lhr-solar/Controls-PedalBoard/README.md

# Controls-PedalBoard
Pedal Daughter Board to mate with the PeripheralSOM for sensing of the linear potentiometers and brake line sensor
