lhr-solar/Controls-PedalBoard/hardware/VCAT-HallEffectPotentiometerPCB/VCAT-HallEffectPotentiometerPCB.step

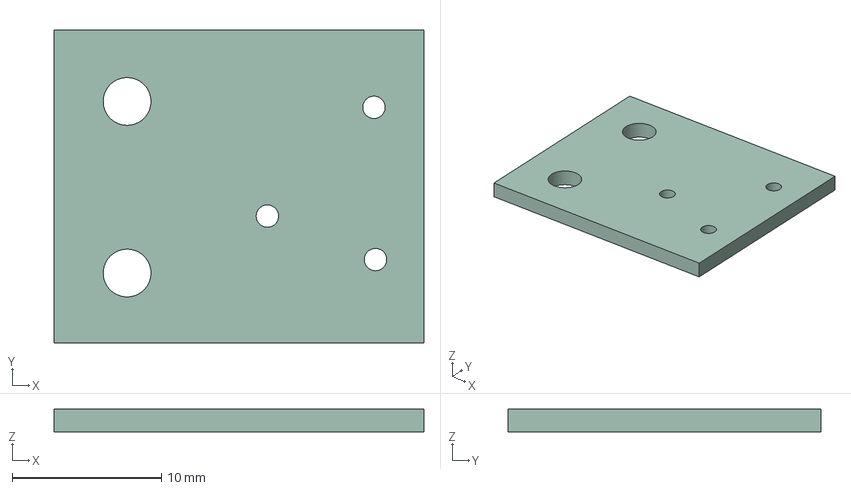
[picture p1: CAD file, 2026-01-18]
hardware/VCAT-HallEffectPotentiometerPCB/VCAT-HallEffectPotentiometerPCB.step
24.8 x 21.0 x 1.51 mm
