lhr-solar/Controls-PedalBoard/hardware/VCAT-PedalBoxPCB/3D Models/INA241A5IDR.stp

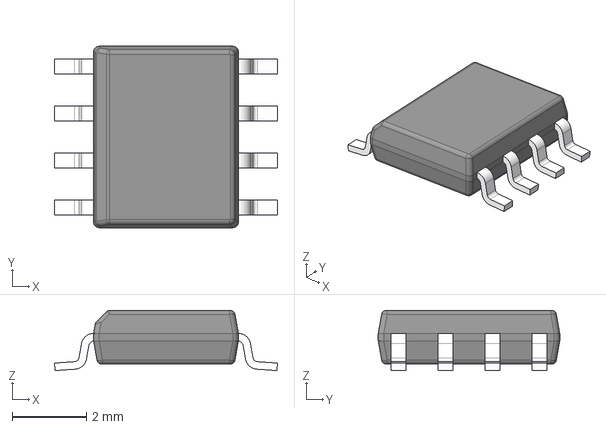
[picture p2: CAD file, 2026-01-18]
hardware/VCAT-PedalBoxPCB/3D Models/INA241A5IDR.stp
6.02 x 4.90 x 1.63 mm
BODY-SO
LEAD-D0008A x 8
