lhr-solar/Controls-PedalBoard/hardware/VCAT-PedalBoxPCB/Controls-PedalsDaughter.step

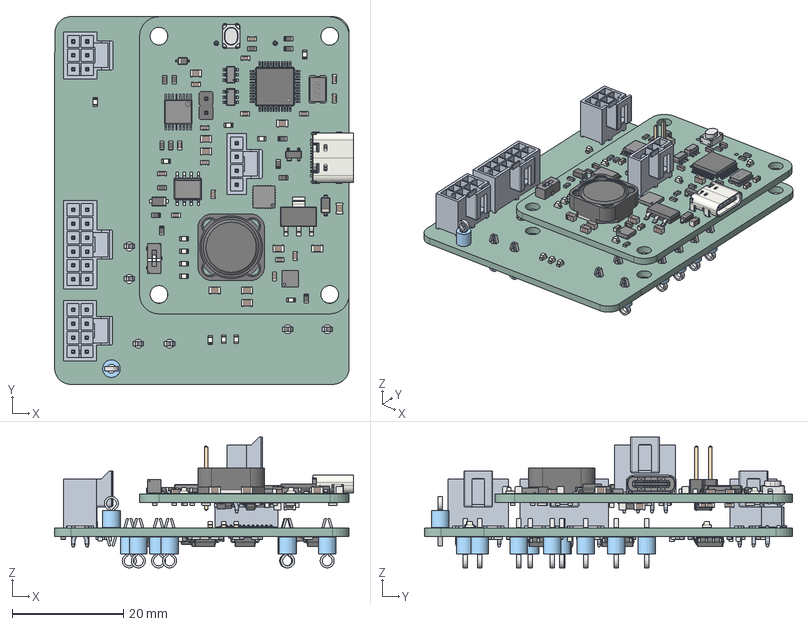
[picture p3: CAD file, 2026-01-18]
hardware/VCAT-PedalBoxPCB/Controls-PedalsDaughter.step
53.8 x 66.2 x 23.6 mm
TestPoint_Keystone_5005-5009_Compact x 17
LED_0603_1608Metric x 13
C_0603_1608Metric x 42
D_SOD-123F x 2
ThermalPin
PinsArrayLR x 3
PinsArrayTB
R_0603_1608Metric x 75
C_0805_2012Metric x 12
LQFP-48_7x7mm_P0.5mm
SOT-223
kicad_embedded_DC8F7DF302591227B9F71E251B6FE682
kicad_embedded_70E7614803E5E4F918B4D78DA69A18BB
L_Coilcraft_MSS1246-XXX
USB_C_Receptacle_GCT_USB4105-xx-A_16P_TopMnt_Horizontal
kicad_embedded_9406EA57197DC5EF7108E35EAA086FA7
BODY-SO x 2
LEAD-D0008A x 8
TL3365AF180QG--3DModel-STEP-520916
BODY-TSSOP
LEAD-TSSOP x 16
PIN1
DAP
SOT-143
D_SOD-123
PinHeader_1x02_P2.54mm_Vertical
D_SOD-323
SOT-23W
LEAD-SO x 8
PeripheralSOM_PCB
SOIC-8_3.9x4.9mm_P1.27mm x 5
term1 x 2
term2 x 2
AP2205-50W5-7 x 2
Controls-PedalsDaughter_PCB
