lhr-solar/Controls-PedalBoard/hardware/VCAT-PedalBoxPCB/3D Models/RI3-1205S.stp

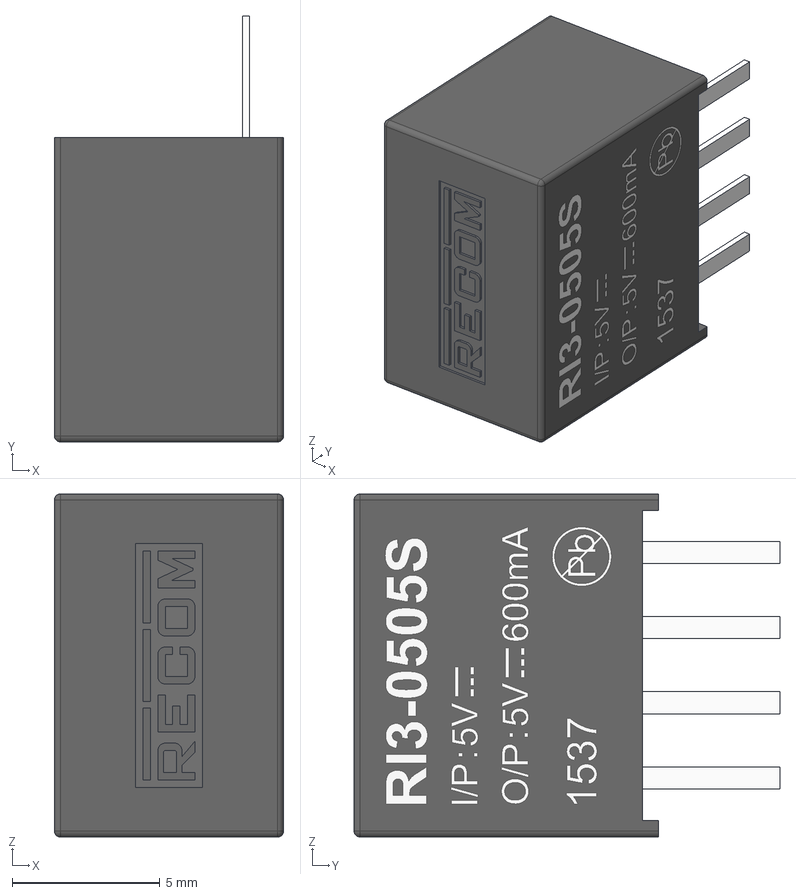
[picture p4: CAD file, 2026-01-18]
hardware/VCAT-PedalBoxPCB/3D Models/RI3-1205S.stp
7.75 x 14.4 x 11.6 mm
