lhr-solar/Controls-PedalBoard/hardware/VCAT-PedalBoxPCB/3D Models/REF5025AID.step

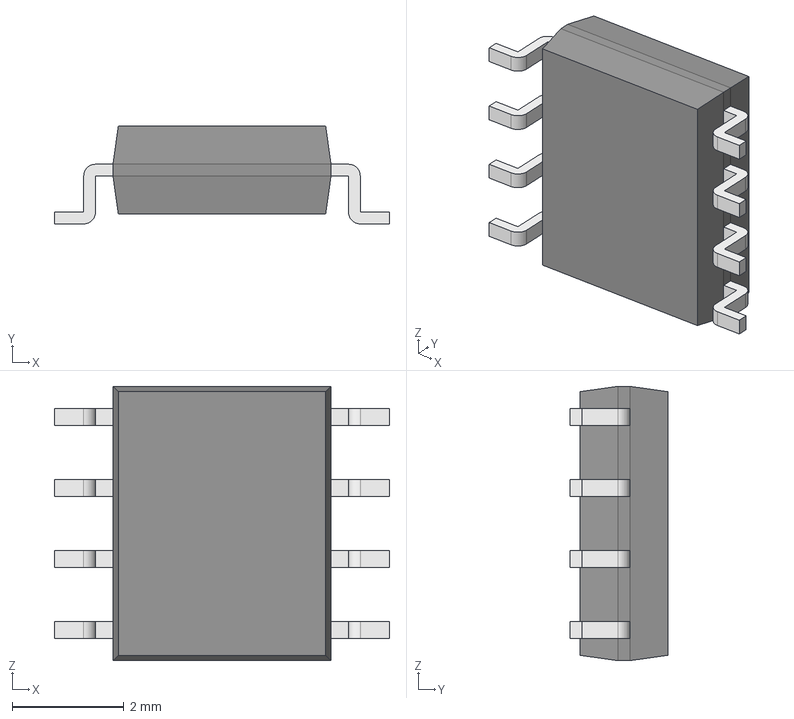
[picture p5: CAD file, 2026-01-18]
hardware/VCAT-PedalBoxPCB/3D Models/REF5025AID.step
5.99 x 1.75 x 4.91 mm
Body001 (Mirror #1) x 4
XY-plane x 12
X-axis x 12
