lhr-solar/Controls-PedalBoard/hardware/VCAT-PedalBoxPCB/3D Models/AP2205-50W5-7.STEP

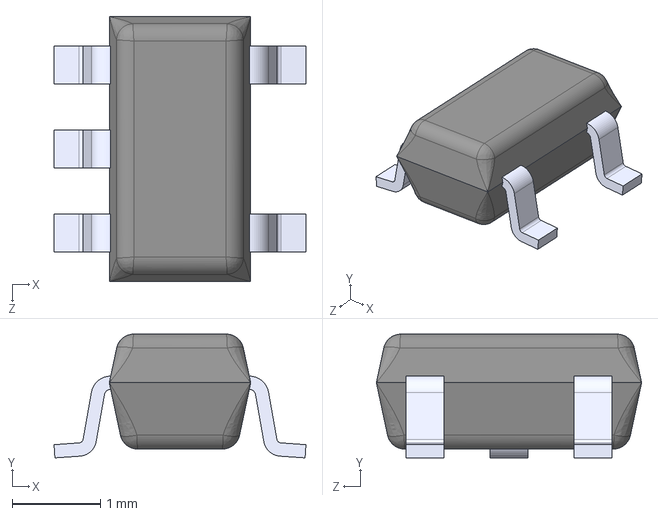
[picture p6: CAD file, 2026-01-18]
hardware/VCAT-PedalBoxPCB/3D Models/AP2205-50W5-7.STEP
2.85 x 1.40 x 3.00 mm
