lhr-solar/Controls-PedalBoard/hardware/VCAT-PedalBoxPCB/3D Models/2x4_vert.stp

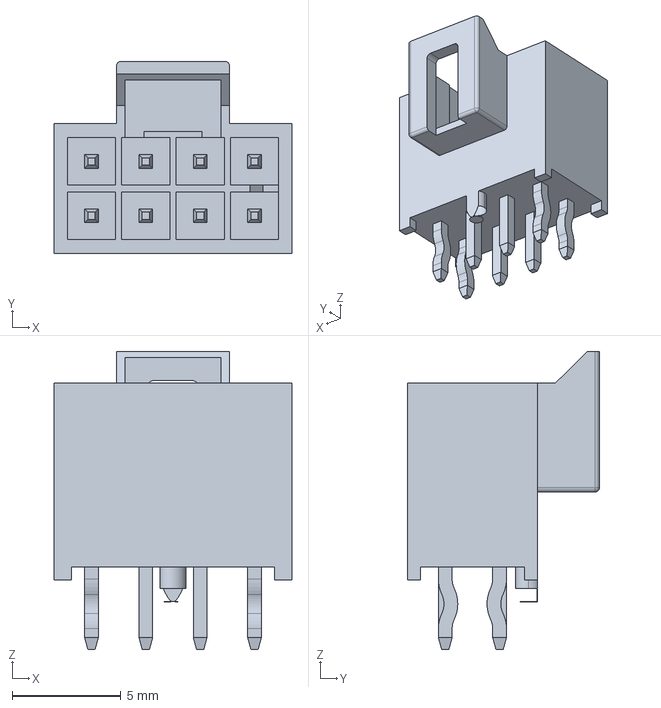
[picture p7: CAD file, 2026-01-18]
hardware/VCAT-PedalBoxPCB/3D Models/2x4_vert.stp
10.9 x 8.84 x 13.7 mm
