lhr-solar/Controls-PedalBoard/hardware/VCAT-PedalBoxPCB/3D Models/2x6_vert.stp

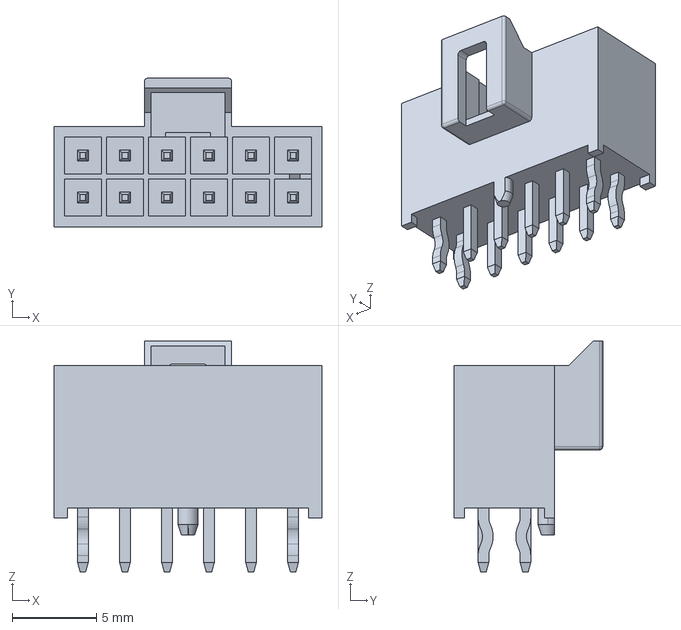
[picture p8: CAD file, 2026-01-18]
hardware/VCAT-PedalBoxPCB/3D Models/2x6_vert.stp
15.9 x 8.84 x 13.7 mm
