lhr-solar/Controls-PedalBoard/hardware/VCAT-PedalBoxPCB/3D Models/AMC1300BDWV.step

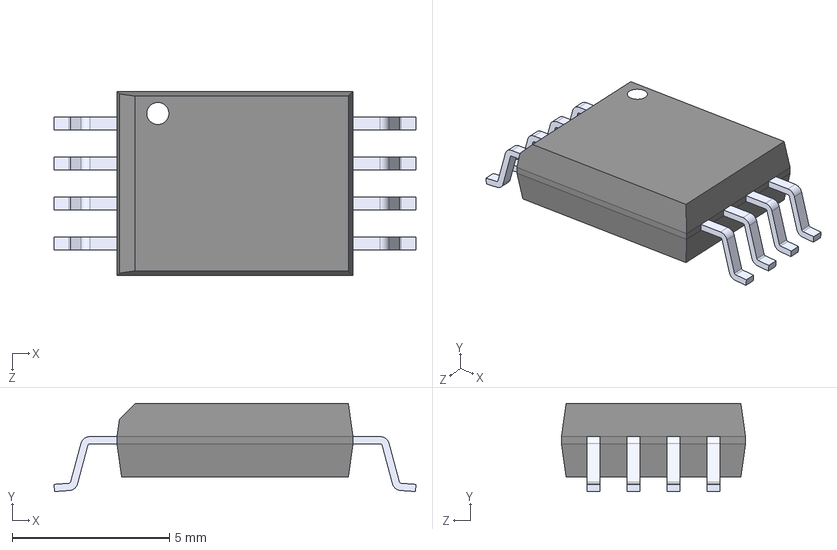
[picture p9: CAD file, 2026-01-18]
hardware/VCAT-PedalBoxPCB/3D Models/AMC1300BDWV.step
11.5 x 2.80 x 5.85 mm
