lhr-solar/Controls-PedalBoard/hardware/VCAT-PedalBoxPCB/3D Models/2x3_vertical_nanofit.stp

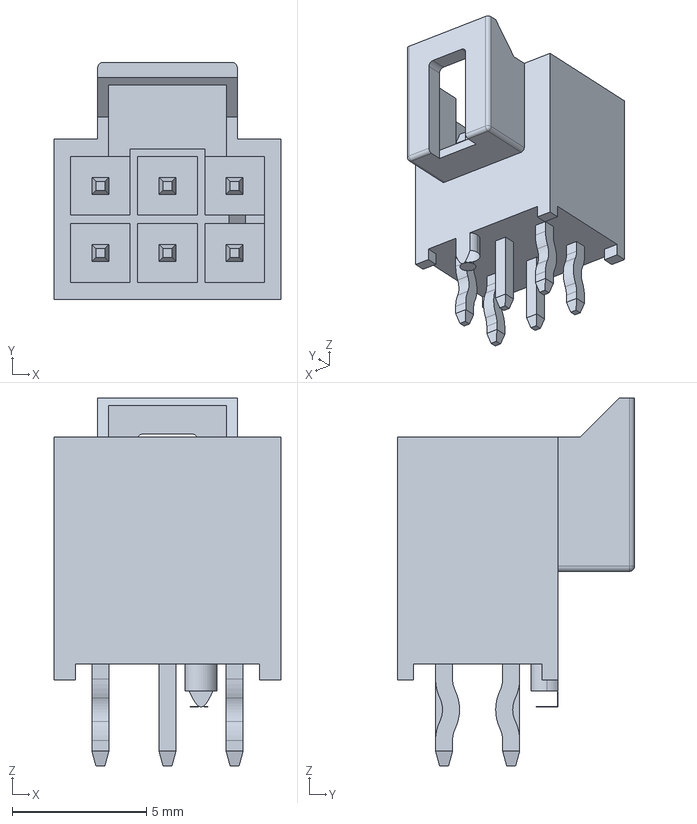
[picture p10: CAD file, 2026-01-18]
hardware/VCAT-PedalBoxPCB/3D Models/2x3_vertical_nanofit.stp
8.44 x 8.84 x 13.7 mm
