lhr-solar/Controls-PedalBoard/hardware/VCAT-PedalBoxPCB/3D Models/ADP7182AUJZ-R7.stp

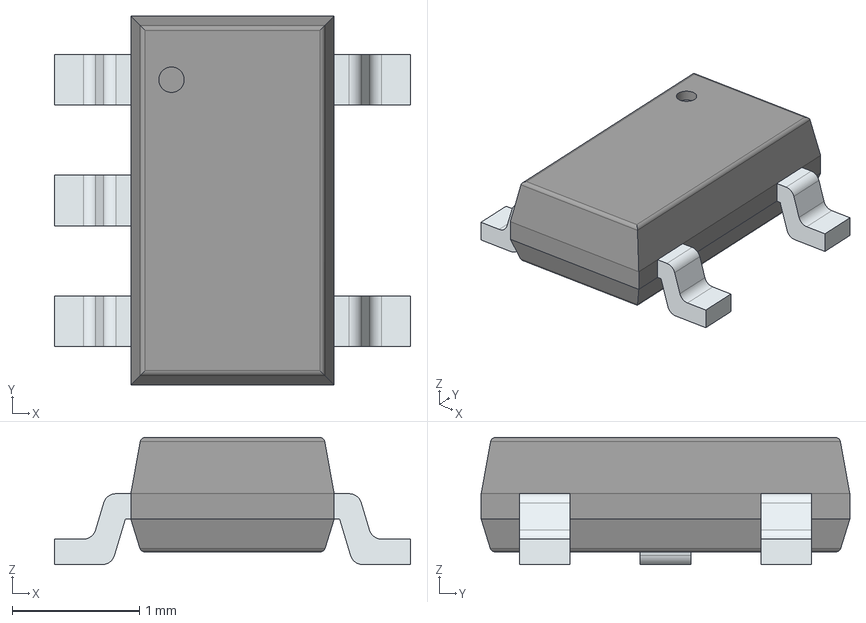
[picture p11: CAD file, 2026-01-18]
hardware/VCAT-PedalBoxPCB/3D Models/ADP7182AUJZ-R7.stp
2.80 x 2.90 x 1.00 mm
PinsArrayL
PinsArrayR
