lhr-solar/Controls-PedalBoard/hardware/VCAT-PedalBoxPCB/3D Models/1x2vert.stp

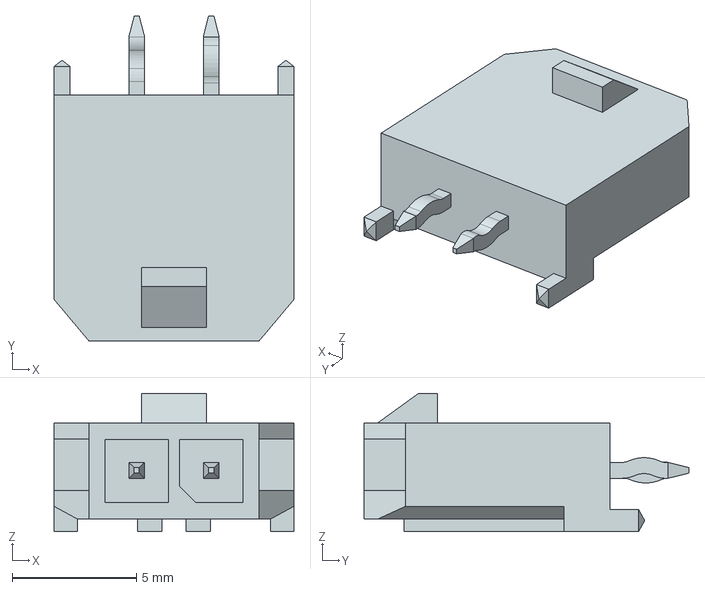
[picture p12: CAD file, 2026-01-18]
hardware/VCAT-PedalBoxPCB/3D Models/1x2vert.stp
9.65 x 13.1 x 5.57 mm
