lhr-solar/Controls-PedalBoard/hardware/VCAT-PedalBoxPCB/3D Models/0603L025YR.stp

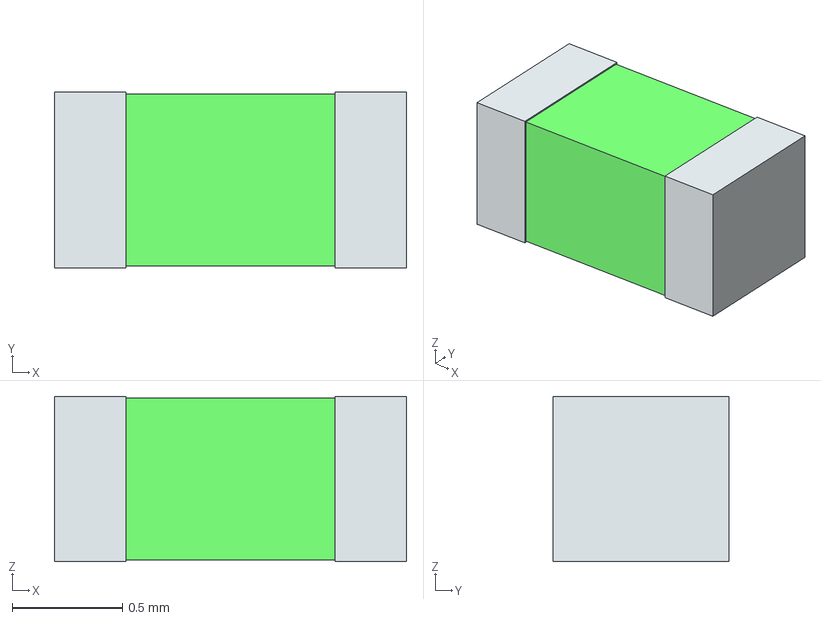
[picture p13: CAD file, 2026-01-18]
hardware/VCAT-PedalBoxPCB/3D Models/0603L025YR.stp
1.60 x 0.8 x 0.75 mm
term1
term2
