lhr-solar/Controls-PedalBoard/hardware/VCAT-PedalBoxPCB/Controls-PedalsDaughter.kicad_pcb

## KiCad design hardware/VCAT-PedalBoxPCB/Controls-PedalsDaughter.kicad_pcb (2026-01-18)

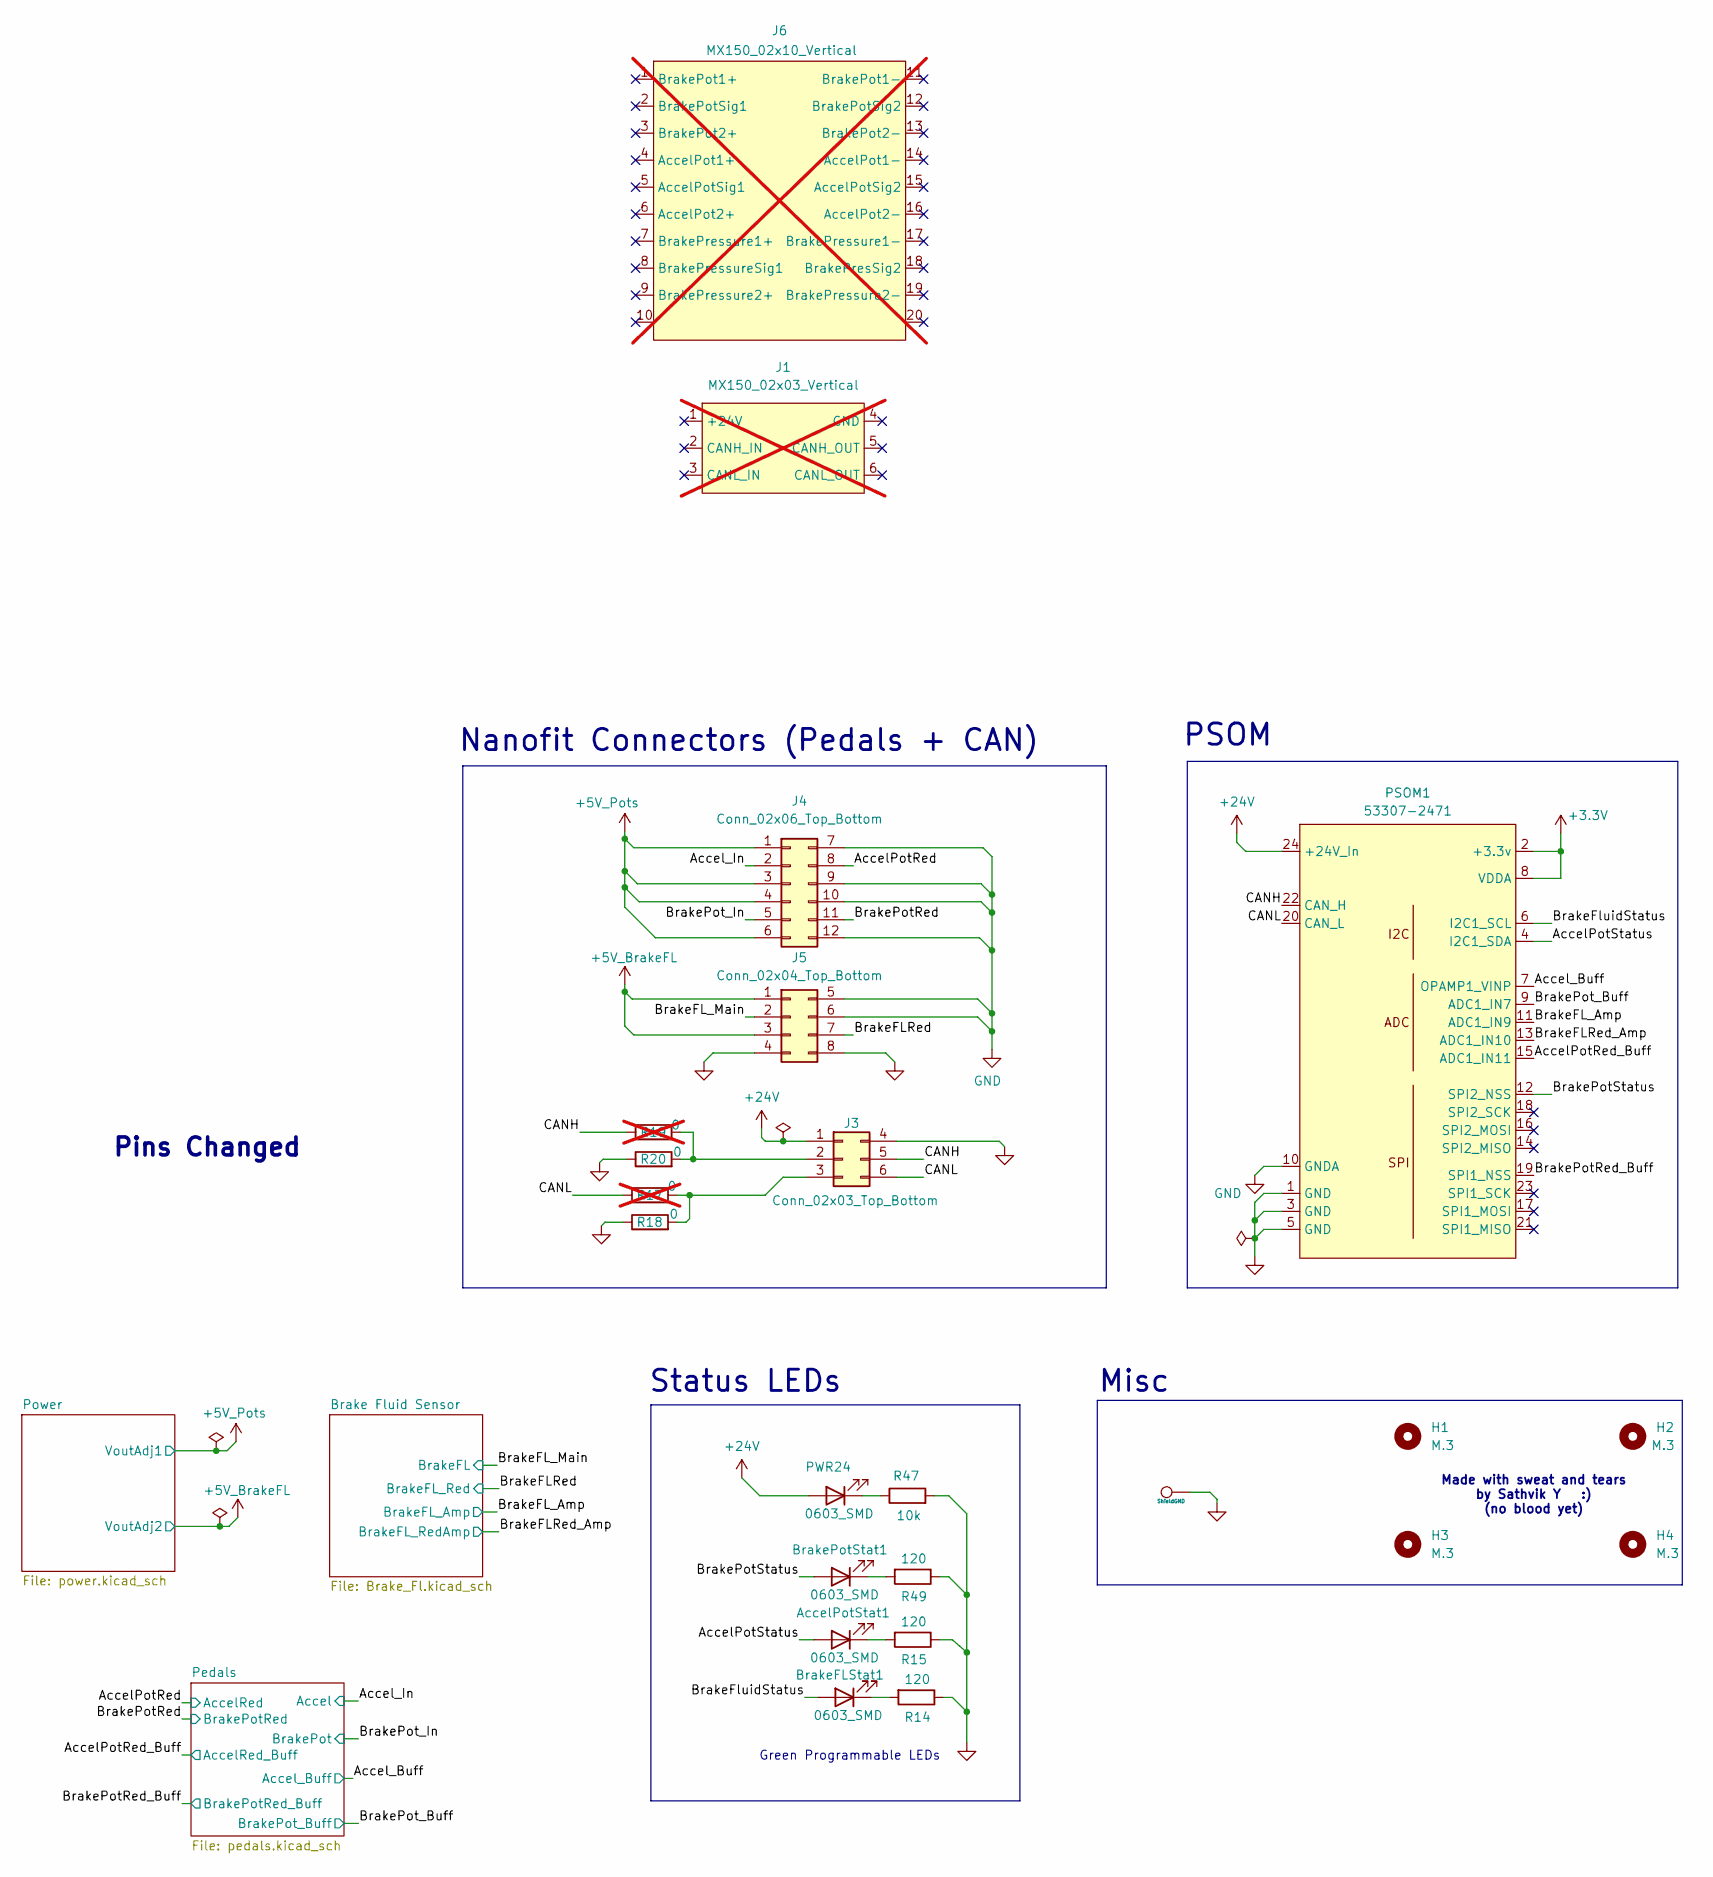
[picture p14: schematic Controls-PedalsDaughter.kicad_sch]

Parts:
AccelPotStat1: 0603_SMD; LED_0603_1608Metric_Pad1.05x0.95mm_HandSolder
BrakeFLStat1: 0603_SMD; LED_0603_1608Metric_Pad1.05x0.95mm_HandSolder
BrakePotStat1: 0603_SMD; LED_0603_1608Metric_Pad1.05x0.95mm_HandSolder
H1, H2, H3, H4: M.3; MountingHole_3.2mm_M3_Pad_TopBottom
J1: MX150_02x03_Vertical; not fitted
J3: Conn_02x03_Top_Bottom; Molex_Nano-Fit_105310-xx06_2x03_P2.50mm_Vertical
J4: Conn_02x06_Top_Bottom; Molex_Nano-Fit_105310-xx12_2x06_P2.50mm_Vertical
J5: Conn_02x04_Top_Bottom; Molex_Nano-Fit_105310-xx08_2x04_P2.50mm_Vertical
J6: MX150_02x10_Vertical; not fitted
PSOM1: 53307-2471; PeripheralSOM
PWR24: 0603_SMD; LED_0603_1608Metric_Pad1.05x0.95mm_HandSolder
R14, R15, R49: 120; R_0603_1608Metric_Pad0.98x0.95mm_HandSolder
R17, R19: 0; R_0603_1608Metric_Pad0.98x0.95mm_HandSolder; not fitted
R18, R20: 0; R_0603_1608Metric_Pad0.98x0.95mm_HandSolder
R47: 10k; R_0603_1608Metric_Pad0.98x0.95mm_HandSolder
Raw6: ShieldGND; TestPoint_Keystone_5005-5009_Compact

Connections:
+3.3V: PSOM1.2 (+3.3v), PSOM1.8 (VDDA); also elsewhere on the board
+5V_BrakeFL: J5.1, J5.3; also elsewhere on the board
+5V_Pots: J4.1, J4.3, J4.4, J4.6; also elsewhere on the board
+24V: J3.1, PSOM1.24 (+24V_In), PWR24.2 (A); also elsewhere on the board
/AccelPotRed: J4.8; also elsewhere on the board
/AccelPotRed_Buff: PSOM1.15 (ADC1_IN11); also elsewhere on the board
/AccelPotStatus: AccelPotStat1.2 (A), PSOM1.4 (I2C1_SDA)
/Accel_Buff: PSOM1.7 (OPAMP1_VINP); also elsewhere on the board
/Accel_In: J4.2; also elsewhere on the board
/BrakeFLRed: J5.7; also elsewhere on the board
/BrakeFLRed_Amp: PSOM1.13 (ADC1_IN10); also elsewhere on the board
/BrakeFL_Amp: PSOM1.11 (ADC1_IN9); also elsewhere on the board
/BrakeFL_Main: J5.2; also elsewhere on the board
/BrakeFluidStatus: BrakeFLStat1.2 (A), PSOM1.6 (I2C1_SCL)
/BrakePotRed: J4.11; also elsewhere on the board
/BrakePotRed_Buff: PSOM1.19 (SPI1_NSS); also elsewhere on the board
/BrakePotStatus: BrakePotStat1.2 (A), PSOM1.12 (SPI2_NSS)
/BrakePot_Buff: PSOM1.9 (ADC1_IN7); also elsewhere on the board
/BrakePot_In: J4.5; also elsewhere on the board
/CANH: J3.5, PSOM1.22 (CAN_H), R19.1
/CANL: J3.6, PSOM1.20 (CAN_L), R17.1
GND: J3.4, J4.7, J4.9, J4.10, J4.12, J5.4, J5.5, J5.6, J5.8, PSOM1.1 (GND), PSOM1.3 (GND), PSOM1.5 (GND), PSOM1.10 (GNDA), R14.1, R15.1, R18.1, R20.1, R47.2, R49.1, Raw6.1; also elsewhere on the board
unnamed: AccelPotStat1.1 (K), R15.2
unnamed: BrakeFLStat1.1 (K), R14.2
unnamed: BrakePotStat1.1 (K), R49.2
unnamed: J3.2, R19.2, R20.2
unnamed: J3.3, R17.2, R18.2
unnamed: PWR24.1 (K), R47.1

Notes on the sheet:
Made with sweat and tears by Sathvik Y :) (no blood yet)
Nanofit Connectors (Pedals + CAN)
PSOM
Green Programmable LEDs
Misc
Pins Changed
Status LEDs

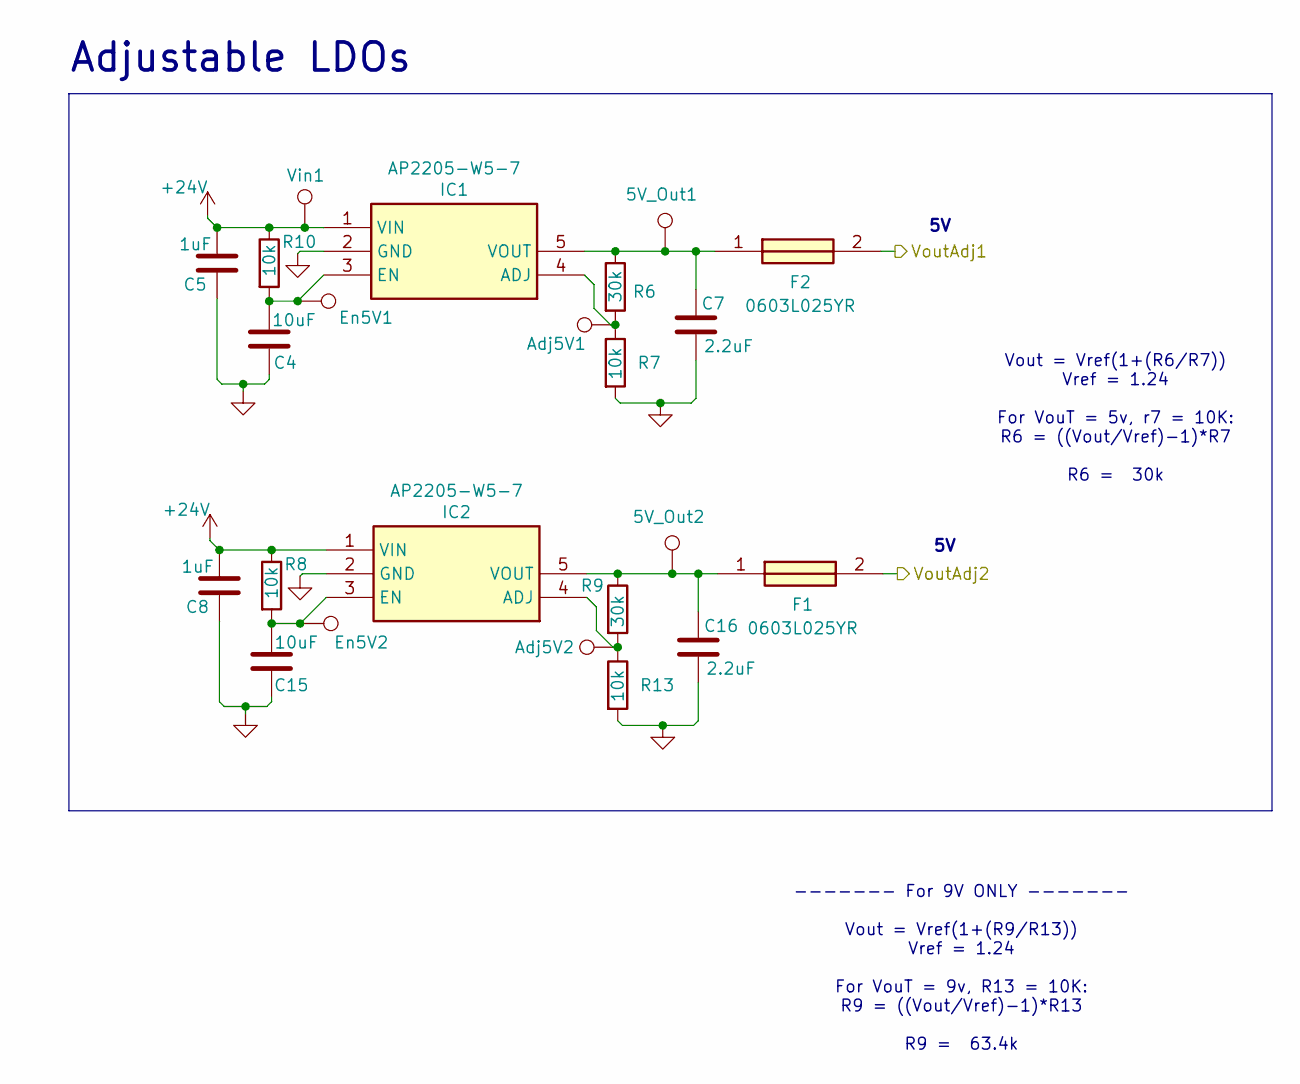
[picture p15: schematic power.kicad_sch]

Parts:
5V_Out1, 5V_Out2: 5V_Out; TestPoint_Pad_1.0x1.0mm
Adj5V1, Adj5V2: Adj5V; TestPoint_Pad_1.0x1.0mm
C4, C15: 10uF; C_0603_1608Metric_Pad1.08x0.95mm_HandSolder
C5, C8: 1uF; C_0603_1608Metric_Pad1.08x0.95mm_HandSolder
C7, C16: 2.2uF; C_0603_1608Metric_Pad1.08x0.95mm_HandSolder
En5V1, En5V2: Enable5V; TestPoint_Pad_1.0x1.0mm
F1, F2: 0603L025YR; FUSC1608X75N; Mouser Part Number 576-0603L025YR
IC1, IC2: AP2205-W5-7; AP2205W57; Mouser Part Number 621-AP2205-W5-7
R6, R9: 30k; R_0603_1608Metric_Pad0.98x0.95mm_HandSolder
R7, R8, R10, R13: 10k; R_0603_1608Metric_Pad0.98x0.95mm_HandSolder
Vin1: Vin; TestPoint_Pad_1.0x1.0mm

Connections:
+5V_BrakeFL: F1.2; also elsewhere on the board
+5V_Pots: F2.2; also elsewhere on the board
+24V: C5.2, C8.2, IC1.1 (VIN), IC2.1 (VIN), R8.1, R10.1, Vin1.1; also elsewhere on the board
GND: C4.1, C5.1, C7.2, C8.1, C15.1, C16.2, IC1.2 (GND), IC2.2 (GND), R7.2, R13.2; also elsewhere on the board
unnamed: Adj5V1.1, IC1.4 (ADJ), R6.2, R7.1
unnamed: C4.2, En5V1.1, IC1.3 (EN), R10.2
unnamed: 5V_Out1.1, C7.1, F2.1, IC1.5 (VOUT), R6.1
unnamed: Adj5V2.1, IC2.4 (ADJ), R9.2, R13.1
unnamed: C15.2, En5V2.1, IC2.3 (EN), R8.2
unnamed: 5V_Out2.1, C16.1, F1.1, IC2.5 (VOUT), R9.1

Notes on the sheet:
------- For 9V ONLY ------- Vout = Vref(1+(R9/R13)) Vref = 1.24 For VouT = 9v, R13 = 10K: R9 = ((Vout/Vref)-1)*R13 R9 = 63.4k
Vout = Vref(1+(R6/R7)) Vref = 1.24 For VouT = 5v, r7 = 10K: R6 = ((Vout/Vref)-1)*R7 R6 = 30k
Adjustable LDOs

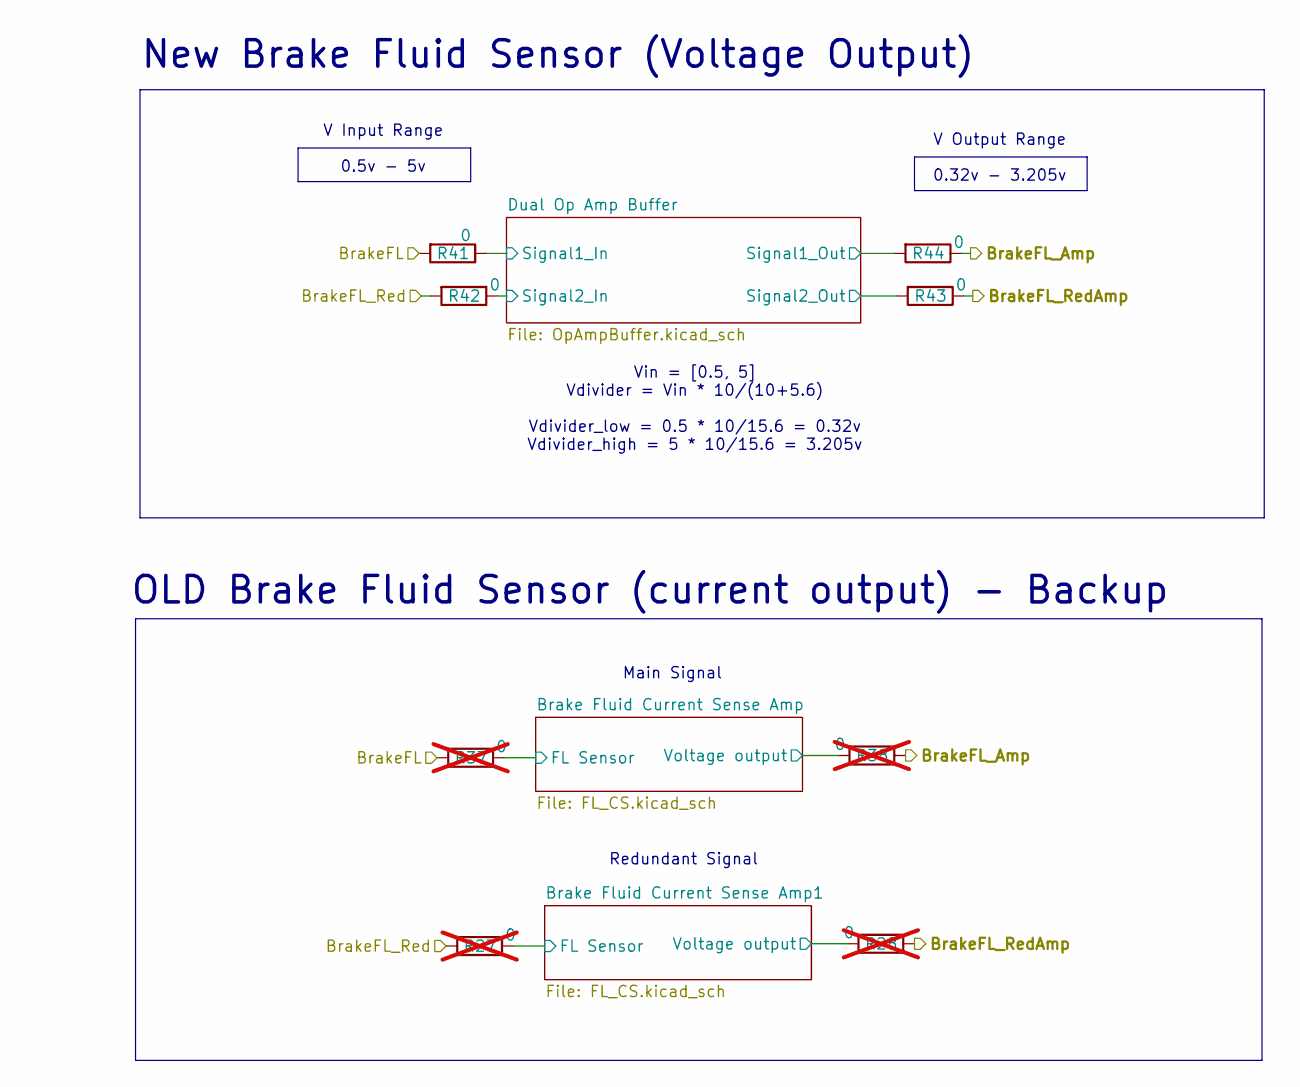
[picture p16: schematic Brake_Fl.kicad_sch]

Parts:
R27, R28, R37, R38: 0; R_0603_1608Metric_Pad0.98x0.95mm_HandSolder; not fitted
R41, R42, R43, R44: 0; R_0603_1608Metric_Pad0.98x0.95mm_HandSolder

Connections:
/Brake Fluid Sensor/Brake Fluid Current Sense Amp1/FL Sensor: R27.1; also elsewhere on the board
/Brake Fluid Sensor/Brake Fluid Current Sense Amp1/Voltage output: R28.2; also elsewhere on the board
/Brake Fluid Sensor/Brake Fluid Current Sense Amp/FL Sensor: R37.1; also elsewhere on the board
/Brake Fluid Sensor/Brake Fluid Current Sense Amp/Voltage output: R38.2; also elsewhere on the board
/Brake Fluid Sensor/Dual Op Amp Buffer/Signal1_In: R41.1; also elsewhere on the board
/Brake Fluid Sensor/Dual Op Amp Buffer/Signal1_Out: R44.2; also elsewhere on the board
/Brake Fluid Sensor/Dual Op Amp Buffer/Signal2_In: R42.1; also elsewhere on the board
/Brake Fluid Sensor/Dual Op Amp Buffer/Signal2_Out: R43.2; also elsewhere on the board
/BrakeFLRed: R27.2, R42.2; also elsewhere on the board
/BrakeFLRed_Amp: R28.1, R43.1; also elsewhere on the board
/BrakeFL_Amp: R38.1, R44.1; also elsewhere on the board
/BrakeFL_Main: R37.2, R41.2; also elsewhere on the board

Notes on the sheet:
New Brake Fluid Sensor (Voltage Output)
OLD Brake Fluid Sensor (current output) - Backup
V Output Range
Main Signal
0.5v - 5v
V Input Range
0.32v - 3.205v
Vin = [0.5, 5] Vdivider = Vin * 10/(10+5.6) Vdivider_low = 0.5 * 10/15.6 = 0.32v Vdivider_high = 5 * 10/15.6 = 3.205v
Redundant Signal

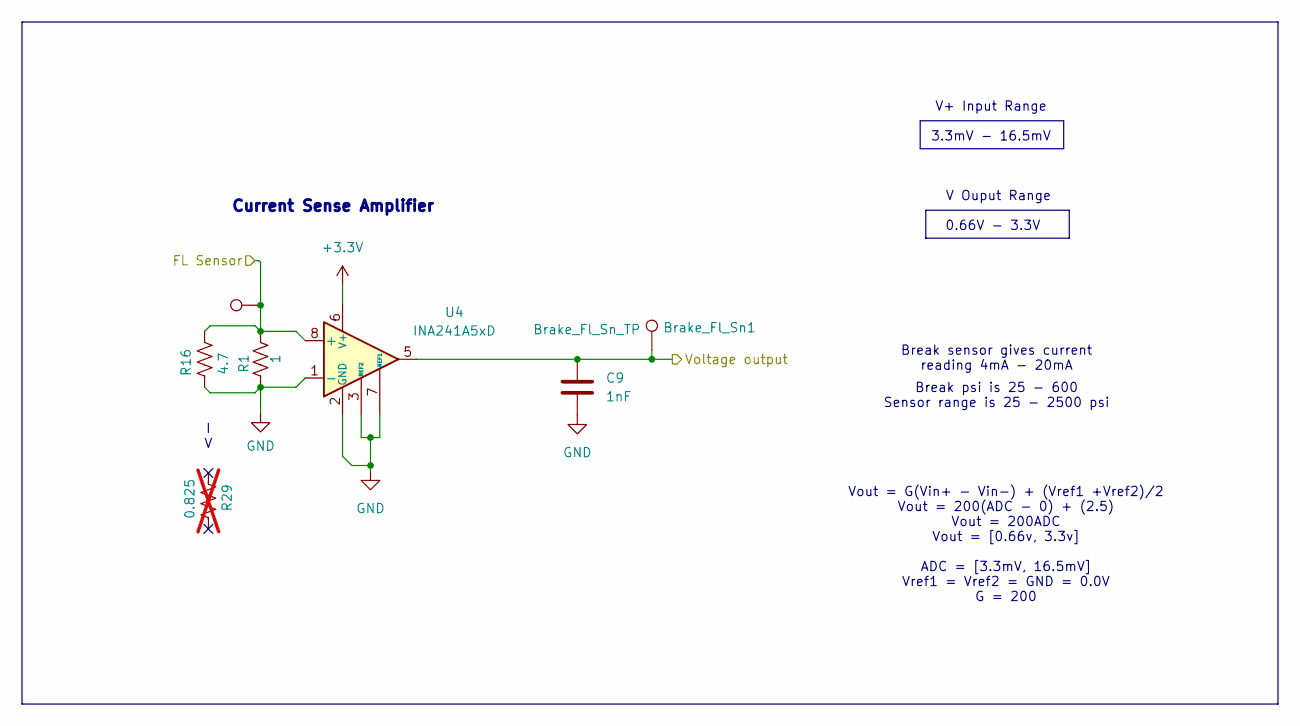
[picture p17: schematic FL_CS.kicad_sch]

Parts:
Brake_Fl_Sn1: Brake_Fl_Sn_TP; TestPoint_Keystone_5005-5009_Compact
C9: 1nF; C_0603_1608Metric_Pad1.08x0.95mm_HandSolder
R1: 1; R_0603_1608Metric_Pad0.98x0.95mm_HandSolder
R16: 4.7; R_0603_1608Metric_Pad0.98x0.95mm_HandSolder
R29: 0.825; R_0603_1608Metric_Pad0.98x0.95mm_HandSolder; not fitted
TP4: Raw_TP; TestPoint_Keystone_5005-5009_Compact
U4: INA241A5xD; SOIC-8_3.9x4.9mm_P1.27mm

Connections:
+3.3V: U4.6 (V+); also elsewhere on the board
/Brake Fluid Sensor/Brake Fluid Current Sense Amp/FL Sensor: R1.2, R16.2, TP4.1, U4.8 (+); also elsewhere on the board
/Brake Fluid Sensor/Brake Fluid Current Sense Amp/Voltage output: Brake_Fl_Sn1.1, C9.1, U4.5; also elsewhere on the board
GND: C9.2, R1.1, R16.1, U4.1 (-), U4.2 (GND), U4.3 (REF2), U4.4 (GND), U4.7 (REF1); also elsewhere on the board

Parts of its further copies:
Brake_Fl_Sn2: Brake_Fl_Sn_TP; TestPoint_Keystone_5005-5009_Compact
C10: 1nF; C_0603_1608Metric_Pad1.08x0.95mm_HandSolder
R30: 4.7; R_0603_1608Metric_Pad0.98x0.95mm_HandSolder
R40: 1; R_0603_1608Metric_Pad0.98x0.95mm_HandSolder
TP5: Raw_TP; TestPoint_Keystone_5005-5009_Compact
U2: INA241A5xD; SOIC-8_3.9x4.9mm_P1.27mm

Connections of its further copies:
+3.3V: U2.6 (V+); also elsewhere on the board
/Brake Fluid Sensor/Brake Fluid Current Sense Amp1/FL Sensor: R30.2, R40.2, TP5.1, U2.8 (+); also elsewhere on the board
/Brake Fluid Sensor/Brake Fluid Current Sense Amp1/Voltage output: Brake_Fl_Sn2.1, C10.1, U2.5; also elsewhere on the board
GND: C10.2, R30.1, R40.1, U2.1 (-), U2.2 (GND), U2.3 (REF2), U2.4 (GND), U2.7 (REF1); also elsewhere on the board

Notes on the sheet:
V+ Input Range
I V
Current Sense Amplifier
Vout = G(Vin+ - Vin-) + (Vref1 +Vref2)/2 Vout = 200(ADC - 0) + (2.5) Vout = 200ADC Vout = [0.66v, 3.3v] ADC = [3.3mV, 16.5mV] Vref1 = Vref2 = GND = 0.0V G = 200
V Ouput Range
0.66V - 3.3V
Break psi is 25 - 600 Sensor range is 25 - 2500 psi
3.3mV - 16.5mV
Break sensor gives current reading 4mA - 20mA

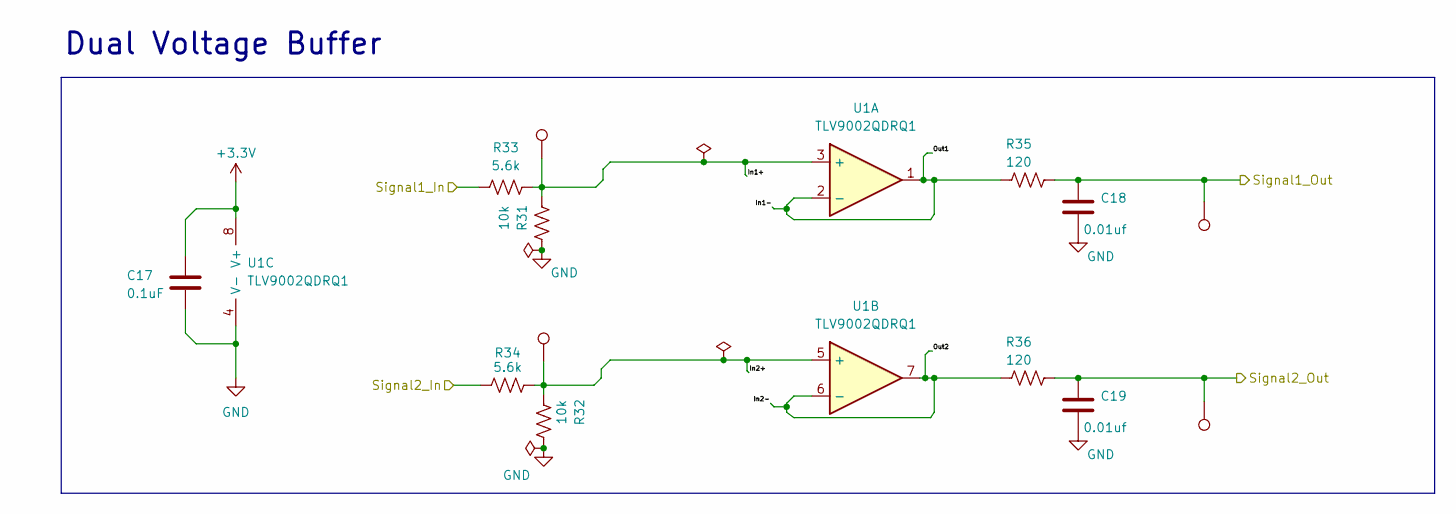
[picture p18: schematic OpAmpBuffer.kicad_sch]

Parts:
C17: 0.1uF; C_0603_1608Metric_Pad1.08x0.95mm_HandSolder
C18, C19: 0.01uf; C_0603_1608Metric_Pad1.08x0.95mm_HandSolder
R31, R32: 10k; R_0603_1608Metric_Pad0.98x0.95mm_HandSolder
R33, R34: 5.6k; R_0603_1608Metric_Pad0.98x0.95mm_HandSolder
R35, R36: 120; R_0603_1608Metric_Pad0.98x0.95mm_HandSolder
TP1, TP6, TP9, TP12: Raw_TP; TestPoint_Keystone_5005-5009_Compact
U1: TLV9002QDRQ1; SOIC-8_3.9x4.9mm_P1.27mm; Mouser P/N 595-TLV9002QDRQ1

Connections:
+3.3V: C17.1, U1.8 (V+); also elsewhere on the board
/Brake Fluid Sensor/Dual Op Amp Buffer/In1+: R31.2, R33.2, TP6.1, U1.3 (+)
/Brake Fluid Sensor/Dual Op Amp Buffer/In1-: R35.2, U1.1, U1.2 (-)
/Brake Fluid Sensor/Dual Op Amp Buffer/In2+: R32.2, R34.2, TP1.1, U1.5 (+)
/Brake Fluid Sensor/Dual Op Amp Buffer/In2-: R36.2, U1.6 (-), U1.7
/Brake Fluid Sensor/Dual Op Amp Buffer/Signal1_In: R33.1; also elsewhere on the board
/Brake Fluid Sensor/Dual Op Amp Buffer/Signal1_Out: C18.2, R35.1, TP9.1; also elsewhere on the board
/Brake Fluid Sensor/Dual Op Amp Buffer/Signal2_In: R34.1; also elsewhere on the board
/Brake Fluid Sensor/Dual Op Amp Buffer/Signal2_Out: C19.2, R36.1, TP12.1; also elsewhere on the board
GND: C17.2, C18.1, C19.1, R31.1, R32.1, U1.4 (V-); also elsewhere on the board

Parts of its further copies:
C1, C6: 0.1uF; C_0603_1608Metric_Pad1.08x0.95mm_HandSolder
C2, C3, C11, C12: 0.01uf; C_0603_1608Metric_Pad1.08x0.95mm_HandSolder
R2, R3, R21, R22: 5.6k; R_0603_1608Metric_Pad0.98x0.95mm_HandSolder
R4, R5, R23, R24: 10k; R_0603_1608Metric_Pad0.98x0.95mm_HandSolder
R11, R12, R25, R26: 120; R_0603_1608Metric_Pad0.98x0.95mm_HandSolder
TP2, TP3, TP7, TP8, TP10, TP11, TP13, TP14: Raw_TP; TestPoint_Keystone_5005-5009_Compact
U3, U5: TLV9002QDRQ1; SOIC-8_3.9x4.9mm_P1.27mm; Mouser P/N 595-TLV9002QDRQ1

Connections of its further copies:
+3.3V: C1.1, C6.1, U3.8 (V+), U5.8 (V+); also elsewhere on the board
/AccelPotRed: R21.1; also elsewhere on the board
/AccelPotRed_Buff: C11.2, R25.1, TP13.1; also elsewhere on the board
/Accel_Buff: C2.2, R11.1, TP7.1; also elsewhere on the board
/Accel_In: R2.1; also elsewhere on the board
/BrakePotRed: R22.1; also elsewhere on the board
/BrakePotRed_Buff: C12.2, R26.1, TP14.1; also elsewhere on the board
/BrakePot_Buff: C3.2, R12.1, TP8.1; also elsewhere on the board
/BrakePot_In: R3.1; also elsewhere on the board
/Pedals/Dual Op Amp Buffer Pots (Redundant)/In1+: R21.2, R23.2, TP10.1, U5.3 (+)
/Pedals/Dual Op Amp Buffer Pots (Redundant)/In1-: R25.2, U5.1, U5.2 (-)
/Pedals/Dual Op Amp Buffer Pots (Redundant)/In2+: R22.2, R24.2, TP11.1, U5.5 (+)
/Pedals/Dual Op Amp Buffer Pots (Redundant)/In2-: R26.2, U5.6 (-), U5.7
/Pedals/Dual Op Amp Buffer Pots (main)/In1+: R2.2, R4.2, TP2.1, U3.3 (+)
/Pedals/Dual Op Amp Buffer Pots (main)/In1-: R11.2, U3.1, U3.2 (-)
/Pedals/Dual Op Amp Buffer Pots (main)/In2+: R3.2, R5.2, TP3.1, U3.5 (+)
/Pedals/Dual Op Amp Buffer Pots (main)/In2-: R12.2, U3.6 (-), U3.7
GND: C1.2, C2.1, C3.1, C6.2, C11.1, C12.1, R4.1, R5.1, R23.1, R24.1, U3.4 (V-), U5.4 (V-); also elsewhere on the board

Notes on the sheet:
Dual Voltage Buffer

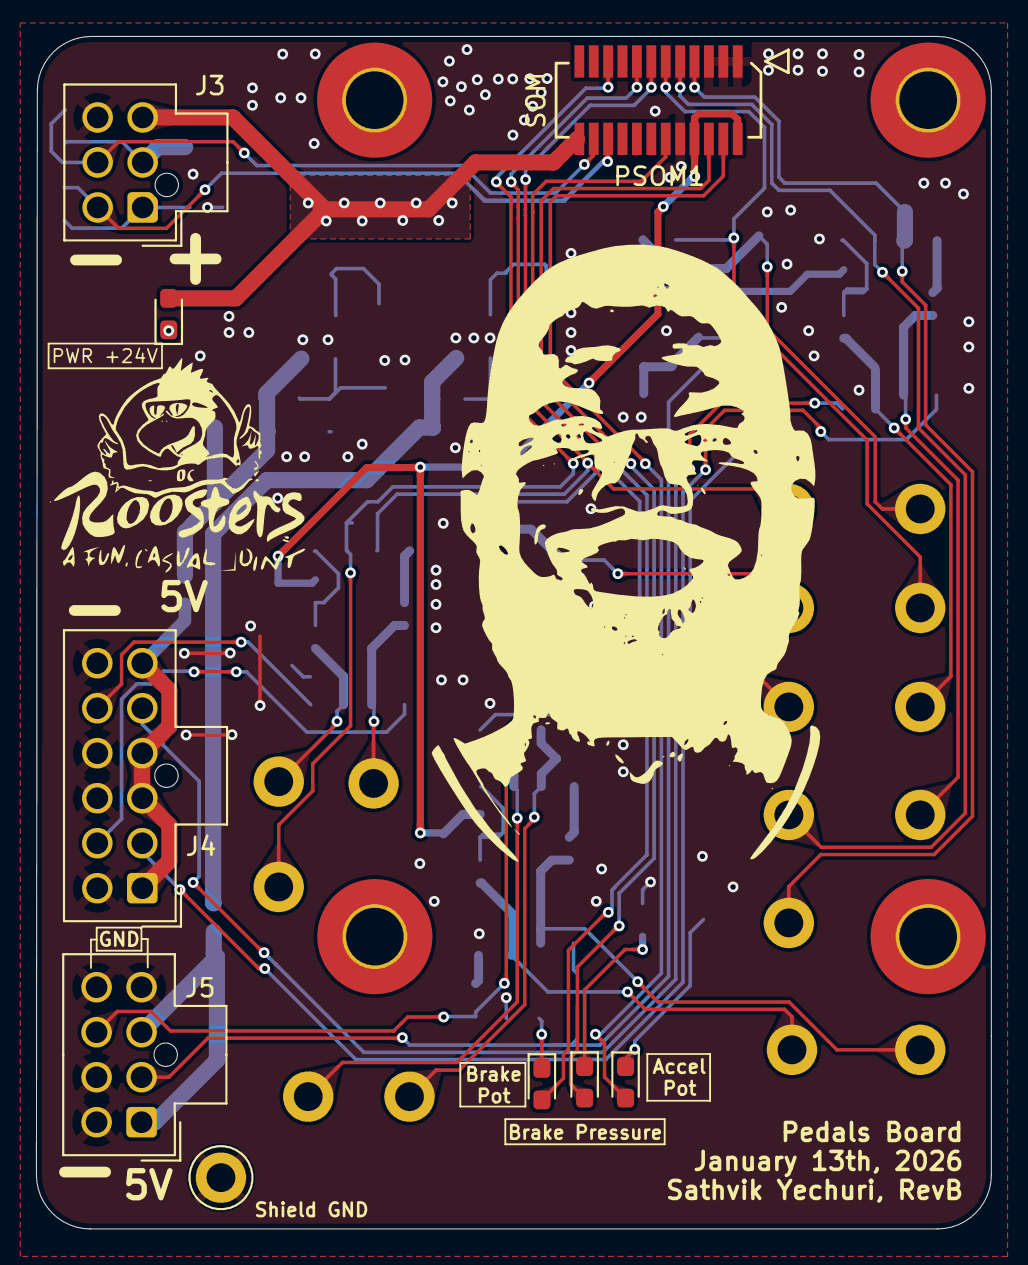
[picture p19: board Controls-PedalsDaughter.kicad_pcb from above]

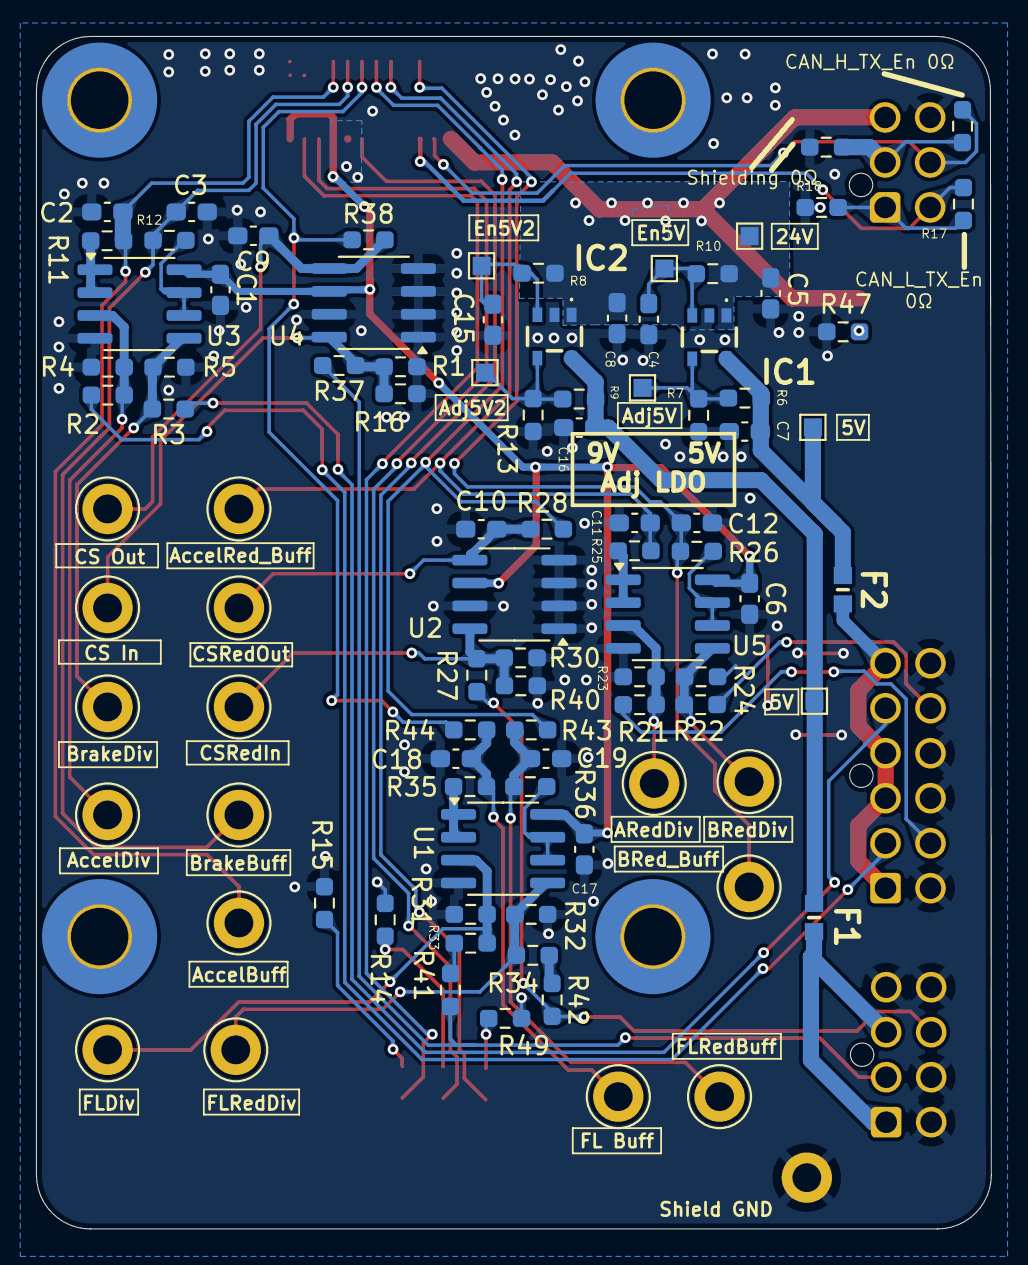
[picture p20: board Controls-PedalsDaughter.kicad_pcb from below]

Board: 2 copper layers, 53.0 x 66.2 mm, 102 parts (93 on the bottom side), 54 nets.
