lhr-solar/Controls-PedalBoard/firmware/tests/multiadc_test.c

#include "Pedals.h"
#include "LUT.h"
#include "StatusLEDs.h"
#include "readAllADCs.h"

#define ADC_TASK_PRIORITY (tskIDLE_PRIORITY + 1)
#define ADC_TASK_STACK_SIZE configMINIMAL_STACK_SIZE
StaticTask_t ADC_Task_TCB;
StackType_t ADC_Task_Stack_Array[ADC_TASK_STACK_SIZE];

int main() {
	HAL_Init();
	SystemClock_Config();
	initPrintf();
	sensors_adc_GPIO_init();
	Status_LEDs_Init();
 
	xTaskCreateStatic(readAll_ADCs_task, 
					  "Multi ADC testing", 
					  ADC_TASK_STACK_SIZE,
					  NULL, ADC_TASK_PRIORITY, 
					  ADC_Task_Stack_Array,
					  &ADC_Task_TCB
	);

	vTaskStartScheduler();

	while (1) {}

	return 0;
}


void readAll_ADCs_task(void *argument) {
	if (sensors_adc_init() != ADC_OK) {
		if (ENABLE_DEBUG) printf("ADC_Init Failed");
		return;
	}
	while (1) {
		if (ENABLE_DEBUG) printf("\033[2J");

		if (sensors_adc_start_read(BRAKE_POT_BUFF_CHANNEL) != ADC_OK)
			if (ENABLE_DEBUG) printf("Brake Pot ADC read failed\n\r");
		if (sensors_adc_start_read(ACCEL_POT_BUFF_CHANNEL) != ADC_OK)
			if (ENABLE_DEBUG) printf("Accel Pot ADC read failed\n\r");
		if (sensors_adc_start_read(BRAKE_FL_FRONT_BUFF_CHANNEL) != ADC_OK)
			if (ENABLE_DEBUG) printf("Brake FL Front ADC read failed\n\r");
		if (sensors_adc_start_read(BRAKE_FL_BACK_BUFF_CHANNEL) != ADC_OK)
			if (ENABLE_DEBUG) printf("Brake FL Back ADC read failed\n\r");
		if (sensors_adc_start_read(ACCEL_POT_REDUNDANT_BUFF_CHANNEL) != ADC_OK)
			if (ENABLE_DEBUG) printf("Accel Pot Redundant ADC read failed\n\r");
		if (sensors_adc_start_read(BRAKE_POT_REDUNDANT_BUFF_CHANNEL) != ADC_OK)
			if (ENABLE_DEBUG) printf("Brake Pot Redundant ADC read failed\n\r");

		uint32_t brakePot_buff_val = 0;
		uint32_t accelPot_buff_val = 0;
		uint32_t brakeFL_front_buff_val = 0;
		uint32_t brakeFL_back_buff_val = 0;
		uint32_t accelPotRed_buff_val = 0;
		uint32_t brakePotRed_buff_val = 0;

		sensors_adc_receive(ADC_INPUT_BRAKE_POT, &brakePot_buff_val);
		if (ENABLE_DEBUG)
			printf("Brake Pot: %lu  |  LUT (%%): %u%%\n\r", brakePot_buff_val,
				   adcPercentBrakeMainLUT[brakePot_buff_val]);
		sensors_adc_receive(ADC_INPUT_ACCEL_POT, &accelPot_buff_val);
		if (ENABLE_DEBUG)
			printf("Accel Pot: %lu  |  LUT (%%): %u%%\n\r", accelPot_buff_val,
				   adcPercentAccelMainLUT[accelPot_buff_val]);
		sensors_adc_receive(ADC_INPUT_BRAKE_POT_REDUNDANT, &brakePotRed_buff_val);
		if (ENABLE_DEBUG)
			printf("Brake Pot Redundant: %lu  |  LUT (%%): %u%%\n\r",
				   brakePotRed_buff_val,
				   adcPercentBrakeRedundantLUT[brakePotRed_buff_val]);
		sensors_adc_receive(ADC_INPUT_ACCEL_POT_REDUNDANT, &accelPotRed_buff_val);
		if (ENABLE_DEBUG)
			printf("Accel Pot Redundant: %lu  |  LUT (%%): %u%%\n\r",
				   accelPotRed_buff_val,
				   adcPercentAccelRedundantLUT[accelPotRed_buff_val]);
		sensors_adc_receive(ADC_INPUT_BRAKE_FL_FRONT, &brakeFL_front_buff_val);
		if (ENABLE_DEBUG) printf("Brake FL Front: %lu\n\r", brakeFL_front_buff_val);
		sensors_adc_receive(ADC_INPUT_BRAKE_FL_BACK, &brakeFL_back_buff_val);

		led_set(BRAKE_POT_LED_PORT, BRAKE_POT_LED_PIN,
				adcPercentBrakeMainLUT[brakePot_buff_val] > 50 ? GPIO_PIN_SET
																 : GPIO_PIN_RESET);
		led_set(ACCEL_POT_LED_PORT, ACCEL_POT_LED_PIN,
				adcPercentAccelMainLUT[accelPot_buff_val] > 50 ? GPIO_PIN_SET
															   : GPIO_PIN_RESET);

		vTaskDelay(pdMS_TO_TICKS(250));
	}
}
