lhr-solar/Controls-PedalBoard/(commit log)

2026-01-18 Rev B - LePedals Board (#4)
    * Initial Commit for Pedals Board
    Break fluid pressure circuitry and excludes potentiometer for the pedal position sensor.
    * Started Pedalboard Brakeline Fluid Sensor
    * Added resister values
    * Deleted Starter Project File. Should be able to open now.
    * Added pedals
    * Combined
    * ERC Fixed
    * Abt to change stuff
    * First Draft
    ✈️
    * Added comments
    * Added isolation n stuff
    * wop
    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
    [0603L025YR.stp, 1x2vert.stp, 2x3_vertical_nanofit.stp, 2x4_vert.stp, 2x6_vert.stp, ADP7182AUJZ-R7.stp, AMC1300BDWV.step, AP2205-50W5-7.STEP]
2026-04-01 Pedals Drivers (#5)
    * Assigned footprints for Power Sector
    * Assigned footprints
    * Added P/Ns
    * Schem done, prelim pcb, added 3d models
    * Fixed 3V3 :P
    * again
    * Yuh
    * expanded board, and made all things go one way
    * errrrrrrkereoem
    * thanks ravi <3
    * added space for latching
    * routed for the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
    [Debugging.c, Debugging.h, GET_FLASHED_test.c, PSOM.ioc, StatusLEDs.c, StatusLEDs.h, debug_test.c, led_test.c]
2026-08-02 Comp prod code
    * routed for the first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
    [CAN_Send_test.c, GET_FLASHED_test.c, HeartbeatTask.c, InitTask.c, InitTask.h, PedalsCAN.c, PedalsCAN.h]
